agendek78/zigbee_led_driver/hw/zigbee_led.kicad_pcb

## KiCad design hw/zigbee_led.kicad_pcb (2023-05-14)

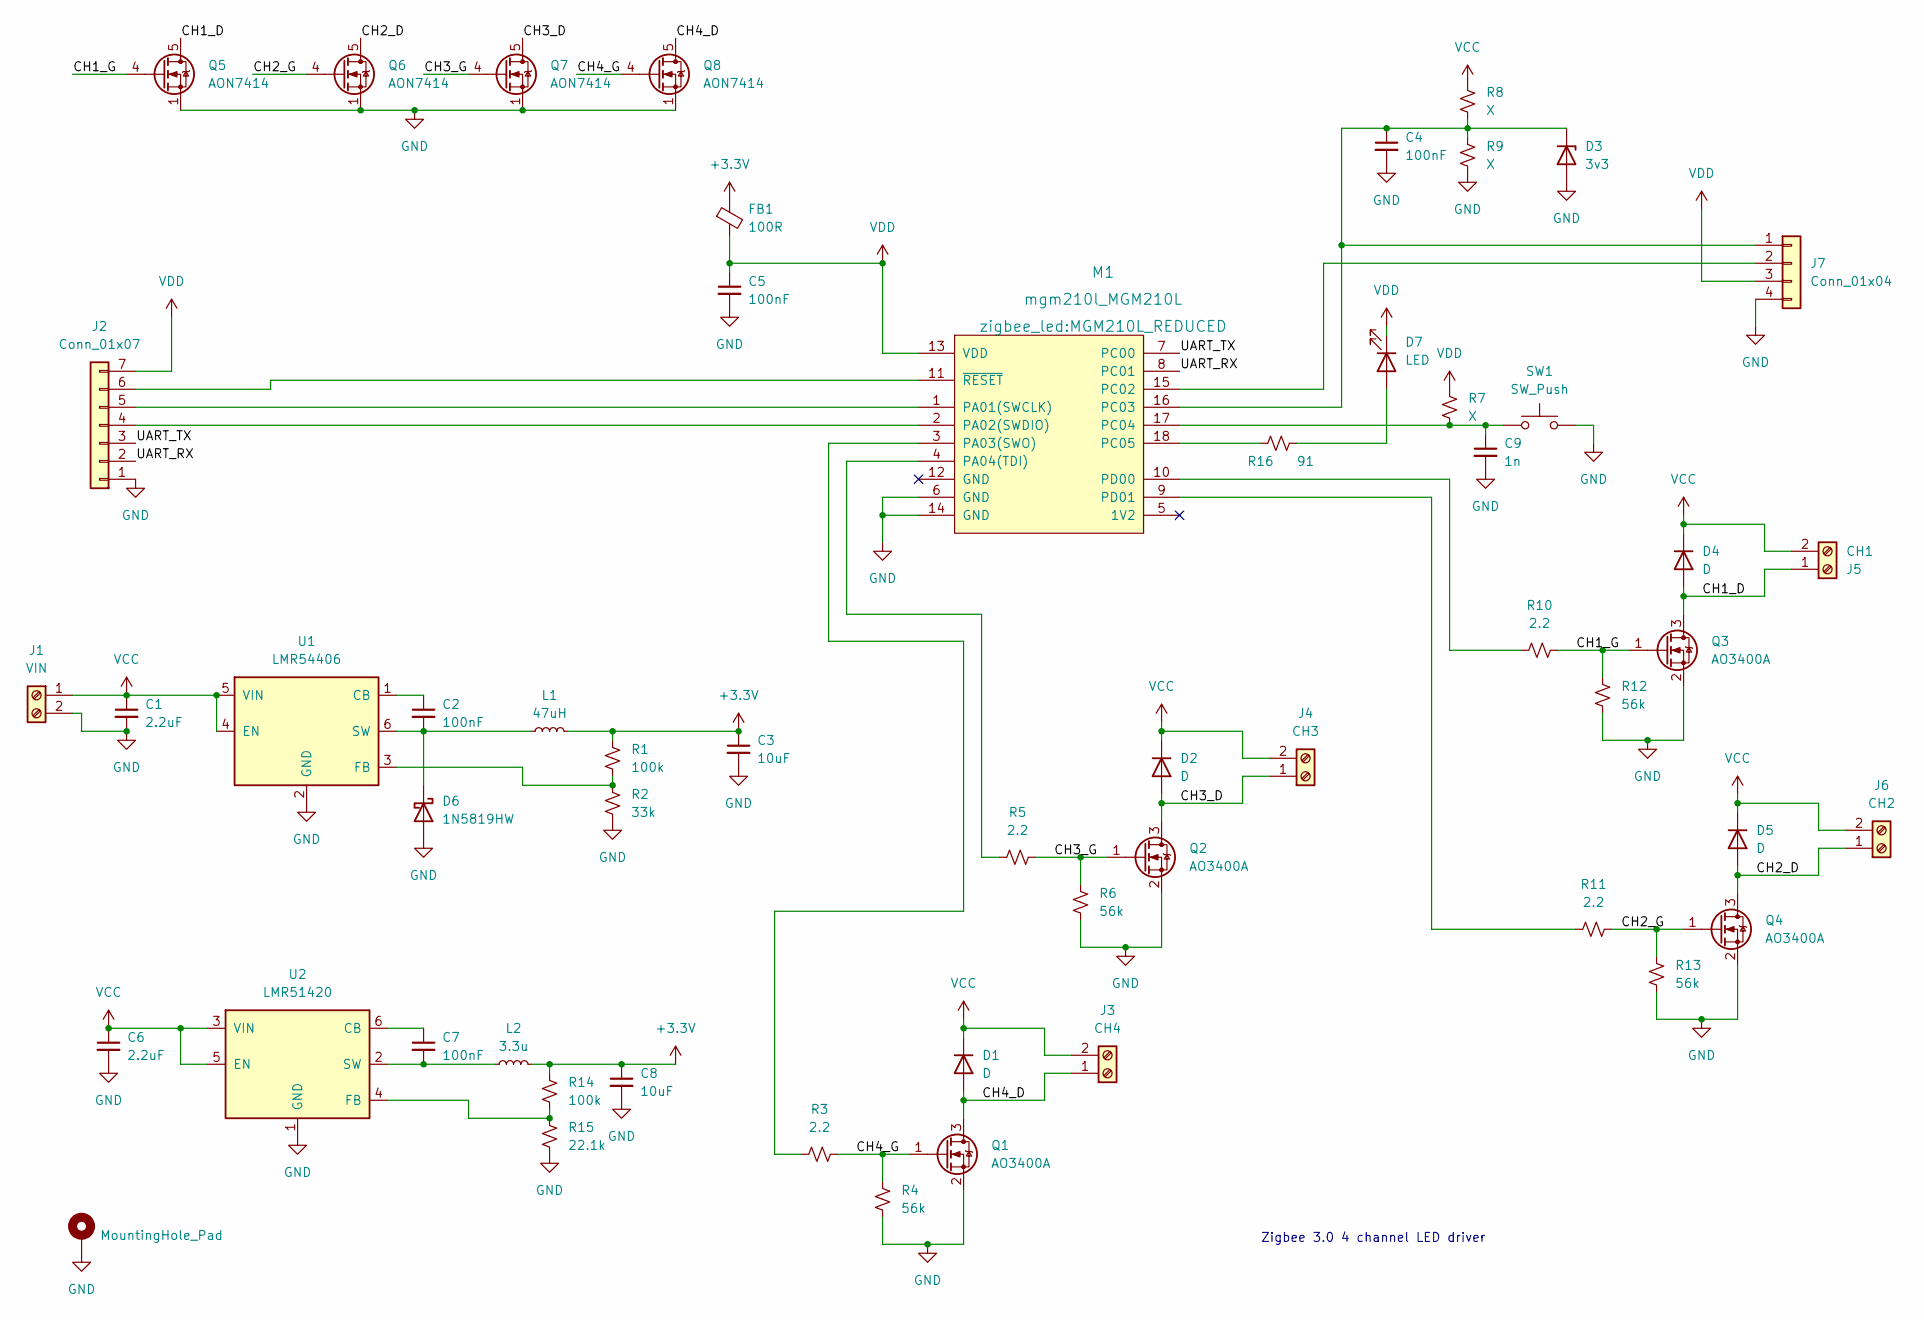
[picture p2: schematic zigbee_led.kicad_sch]

Parts:
C1, C6: 2.2uF; C_0603_1608Metric
C2, C7: 100nF; C_0603_1608Metric
C3, C8: 10uF; C_0805_2012Metric
C4, C5: 100nF; C_0402_1005Metric
C9: 1n; C_0402_1005Metric
D1, D2, D4, D5: D; D_MiniMELF
D3: 3v3; D_MiniMELF
D6: 1N5819HW; D_SOD-123
D7: LED; D_0603_1608Metric
FB1: 100R; C_0603_1608Metric
H1: MountingHole_Pad; MountingHole_3.2mm_M3_DIN965_Pad_TopBottom
J1: VIN; TerminalBlock_Phoenix_PT-1,5-2-3.5-H_1x02_P3.50mm_Horizontal
J2: Conn_01x07; PinHeader_1x07_P2.54mm_Vertical
J3: CH4; TerminalBlock_Phoenix_PT-1,5-2-3.5-H_1x02_P3.50mm_Horizontal
J4: CH3; TerminalBlock_Phoenix_PT-1,5-2-3.5-H_1x02_P3.50mm_Horizontal
J5: CH1; TerminalBlock_Phoenix_PT-1,5-2-3.5-H_1x02_P3.50mm_Horizontal
J6: CH2; TerminalBlock_Phoenix_PT-1,5-2-3.5-H_1x02_P3.50mm_Horizontal
J7: Conn_01x04; PinHeader_1x04_P2.54mm_Vertical
L1: 47uH; L_Taiyo-Yuden_MD-4040
L2: 3.3u; L_Taiyo-Yuden_MD-4040
M1: mgm210l_MGM210L; MGM210L_REDUCED
Q1, Q2, Q3, Q4: AO3400A; SOT-23
Q5, Q6, Q7, Q8: AON7414; dual_mos
R1, R14: 100k; R_0402_1005Metric
R2: 33k; R_0402_1005Metric
R3, R5, R10, R11: 2.2; R_0402_1005Metric
R4, R6, R12, R13: 56k; R_0402_1005Metric
R7, R8, R9: X; R_0402_1005Metric
R15: 22.1k; R_0402_1005Metric
R16: 91; R_0603_1608Metric
SW1: SW_Push; SW_SPST_CK_RS282G05A3
U1: LMR54406; SOT-23-6
U2: LMR51420; SOT-23-6

Connections:
+3V3: C3.1, C8.1, FB1.1, L1.2, L2.2, R1.1, R14.1
/CH1_D: D4.2 (A), J5.1, Q3.3 (D), Q5.5 (D)
/CH1_G: Q3.1 (G), Q5.4 (G), R10.2, R12.1
/CH2_D: D5.2 (A), J6.1, Q4.3 (D), Q6.5 (D)
/CH2_G: Q4.1 (G), Q6.4 (G), R11.2, R13.1
/CH3_D: D2.2 (A), J4.1, Q2.3 (D), Q7.5 (D)
/CH3_G: Q2.1 (G), Q7.4 (G), R5.2, R6.1
/CH4_D: D1.2 (A), J3.1, Q1.3 (D), Q8.5 (D)
/CH4_G: Q1.1 (G), Q8.4 (G), R3.2, R4.1
/UART_RX: J2.2, M1.8 (PC01)
/UART_TX: J2.3, M1.7 (PC00)
GND: C1.2, C3.2, C4.2, C5.2, C6.2, C8.2, C9.2, D3.2 (A), D6.2 (A), H1.1, J1.2, J2.1, J7.4, M1.6 (GND), M1.14 (GND), Q1.2 (S), Q2.2 (S), Q3.2 (S), Q4.2 (S), Q5.1 (S), Q5.2 (S), Q5.3 (S), Q6.1 (S), Q6.2 (S), Q6.3 (S), Q7.1 (S), Q7.2 (S), Q7.3 (S), Q8.1 (S), Q8.2 (S), Q8.3 (S), R2.2, R4.2, R6.2, R9.2, R12.2, R13.2, R15.2, SW1.2, U1.2 (GND), U2.1 (GND)
unnamed: C2.1, U1.1 (CB)
unnamed: C2.2, D6.1 (K), L1.1, U1.6 (SW)
unnamed: C4.1, D3.1 (K), J7.1, M1.16 (PC03), R8.2, R9.1
unnamed: C7.1, U2.6 (CB)
unnamed: C7.2, L2.1, U2.2 (SW)
unnamed: C9.1, M1.17 (PC04), R7.2, SW1.1
unnamed: D7.2 (A), R16.2
unnamed: J2.4, M1.2 (PA02(SWDIO))
unnamed: J2.5, M1.1 (PA01(SWCLK))
unnamed: J2.6, M1.11 (~RESET)
unnamed: J7.2, M1.15 (PC02)
unnamed: M1.3 (PA03(SWO)), R3.1
unnamed: M1.4 (PA04(TDI)), R5.1
unnamed: M1.9 (PD01), R11.1
unnamed: M1.10 (PD00), R10.1
unnamed: M1.18 (PC05), R16.1
unnamed: R1.2, R2.1, U1.3 (FB)
unnamed: R14.2, R15.1, U2.4 (FB)
VCC: C1.1, C6.1, D1.1 (K), D2.1 (K), D4.1 (K), D5.1 (K), J1.1, J3.2, J4.2, J5.2, J6.2, R8.1, U1.4 (EN), U1.5 (VIN), U2.3 (VIN), U2.5 (EN)
VDD: C5.1, D7.1 (K), FB1.2, J2.7, J7.3, M1.13 (VDD), R7.1

Notes on the sheet:
Zigbee 3.0 4 channel LED driver

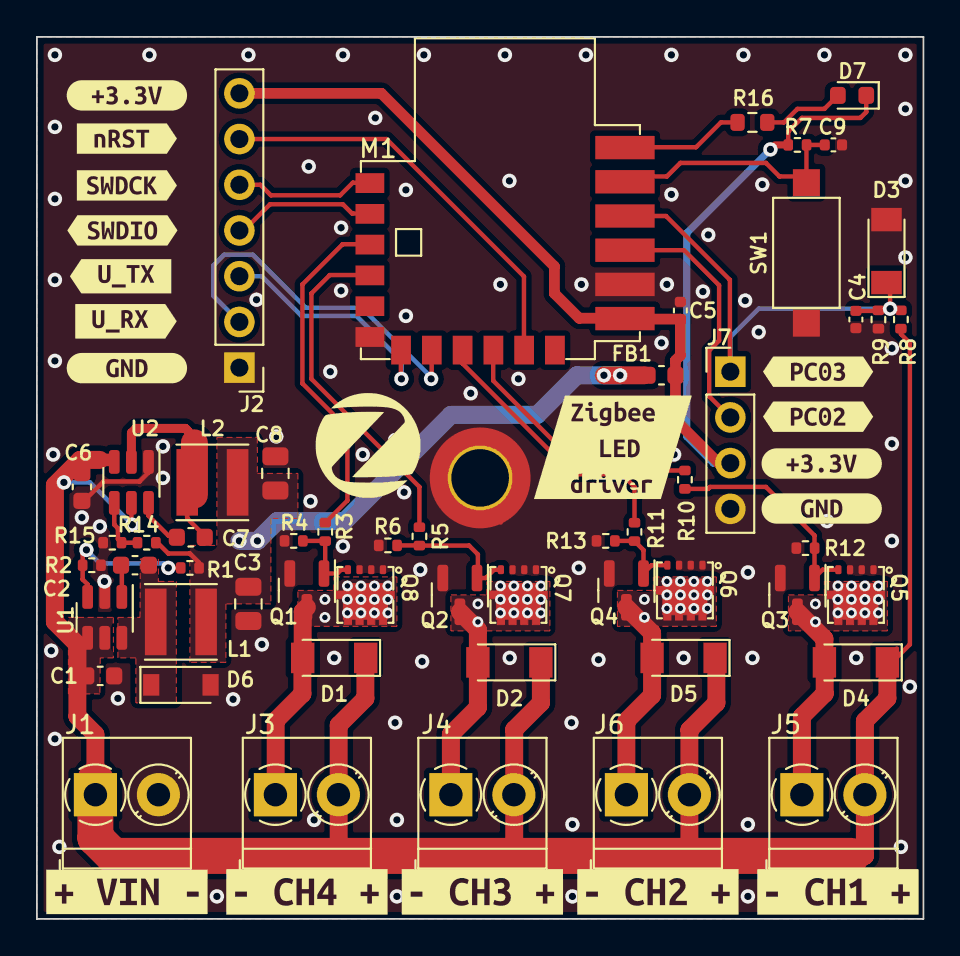
[picture p3: board zigbee_led.kicad_pcb from above]

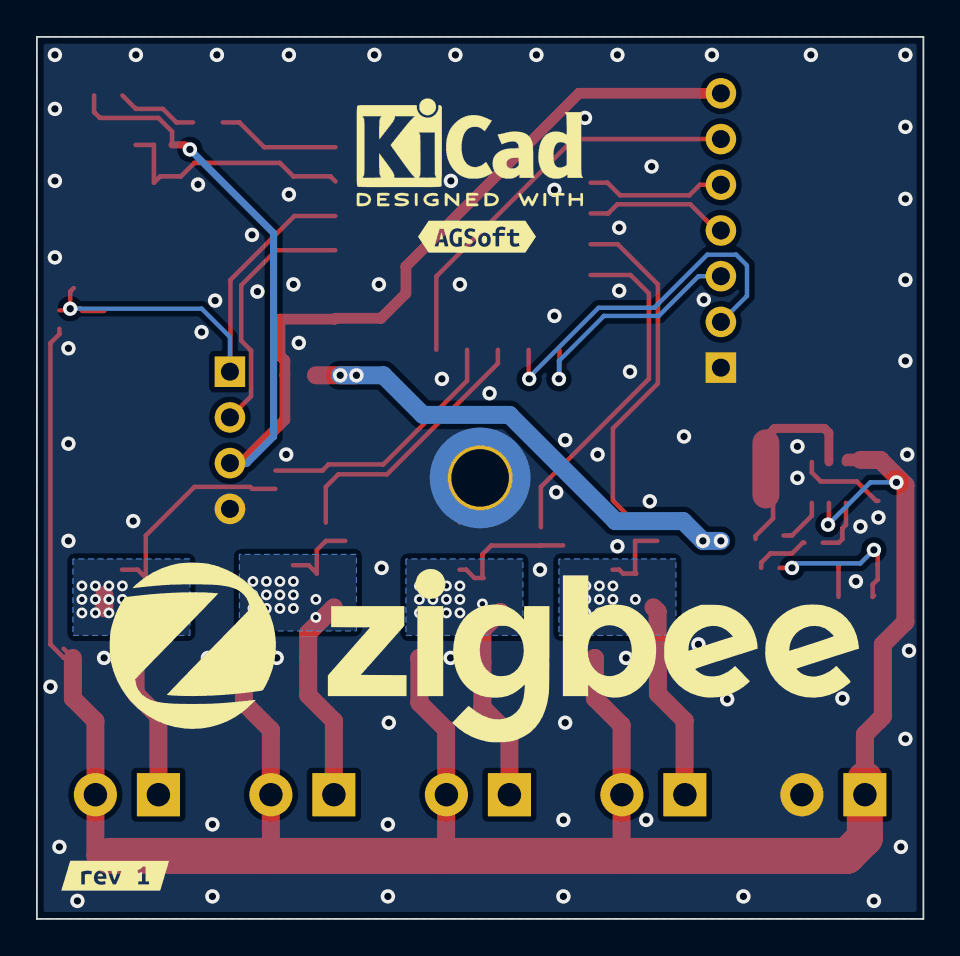
[picture p4: board zigbee_led.kicad_pcb from below]

Board: 2 copper layers, 49.2 x 49.0 mm, 74 parts (2 on the bottom side), 32 nets.

Other parts of the board:
kibuzzard-62FBDFF0: G***; kibuzzard-62FBDFF0
kibuzzard-62FBE01C: G***; kibuzzard-62FBE01C
kibuzzard-62FBE02B: G***; kibuzzard-62FBE02B
kibuzzard-62FBE006: G***; kibuzzard-62FBE006
kibuzzard-62FBE011: G***; kibuzzard-62FBE011
kibuzzard-635D774E: G***; kibuzzard-635D774E
kibuzzard-635D775C: G***; kibuzzard-635D775C
kibuzzard-6301F9AD, kibuzzard-6301F9AD#2: G***; kibuzzard-6301F9AD
kibuzzard-6301F96E: G***; kibuzzard-6301F96E
kibuzzard-6301F99C: G***; kibuzzard-6301F99C
kibuzzard-6301F961: G***; kibuzzard-6301F961
kibuzzard-6301F990: G***; kibuzzard-6301F990
kibuzzard-6301FC13: G***; kibuzzard-6301FC13
kibuzzard-6301FC25, kibuzzard-6301FC25#2: G***; kibuzzard-6301FC25
kibuzzard-63020F3A: G***; kibuzzard-63020F3A
kibuzzard-63020FF5: G***; kibuzzard-63020FF5
kibuzzard-63611416: G***; kibuzzard-63611416
