agendek78/zigbee_led_driver/main.c

/*
 *  Zigbee 3.0 4-channel LED strip driver.
 *  Copyright (C) 2022 Andrzej Gendek
 *
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
 *  You should have received a copy of the GNU General Public License
 *  along with this program.  If not, see <https://www.gnu.org/licenses/>.
 */

#include "sl_component_catalog.h"
#include "sl_system_init.h"
#if defined(SL_CATALOG_POWER_MANAGER_PRESENT)
#include "sl_power_manager.h"
#endif
#if defined(SL_CATALOG_KERNEL_PRESENT)
#include "sl_system_kernel.h"
#else
#include "sl_system_process_action.h"
#endif // SL_CATALOG_KERNEL_PRESENT

#ifdef EMBER_TEST
#define main nodeMain
#endif

extern void app_init(void);

void app_process_action(void)
{
}

int main(void)
{
  // Initialize Silicon Labs device, system, service(s) and protocol stack(s).
  // Note that if the kernel is present, processing task(s) will be created by
  // this call.
  sl_system_init();

  // Initialize the application. For example, create periodic timer(s) or
  // task(s) if the kernel is present.
  app_init();

#if defined(SL_CATALOG_KERNEL_PRESENT)
  // Start the kernel. Task(s) created in app_init() will start running.
  sl_system_kernel_start();
#else // SL_CATALOG_KERNEL_PRESENT
  while (1) {
    // Do not remove this call: Silicon Labs components process action routine
    // must be called from the super loop.
    sl_system_process_action();

    // Application process.
    app_process_action();

    // Let the CPU go to sleep if the system allow it.
#if defined(SL_CATALOG_POWER_MANAGER_PRESENT)
    sl_power_manager_sleep();
#endif // SL_CATALOG_POWER_MANAGER_PRESENT
  }
#endif // SL_CATALOG_KERNEL_PRESENT

  return 0;
}
