agendek78/zigbee_led_driver/(commit log)

2023-05-14 Add hardware KiCAD project
    [zigbee_led.kicad_pcb, zigbee_led.kicad_sch]
2023-12-31 Refactor LEVEL cluster code
    - disable Silabs Level server cluster implementation
    and replace it with own
    - fix restoring default attribute values on factory reset
    - add 'Release' configuration
    [app.c, app.h, button.c, dbg_log.h, led_effect.c, level_extension.c, level_extension.h, on_off_extension.c]
